rbridal/smart-blast-gate-controller/README.md

# Smart Blast Gate Controller

Automatic dust collection for a small shop: two servo-driven 2½″ ball valves
(Shapeoko CNC + spot hose) on an ESP32 running ESPHome, reed switches at both
end stops of each valve, a round touch display for status/override, and Home
Assistant deciding *when* suction is wanted (spindle current via Shelly EM,
buttons, display taps) and switching the shop vac.

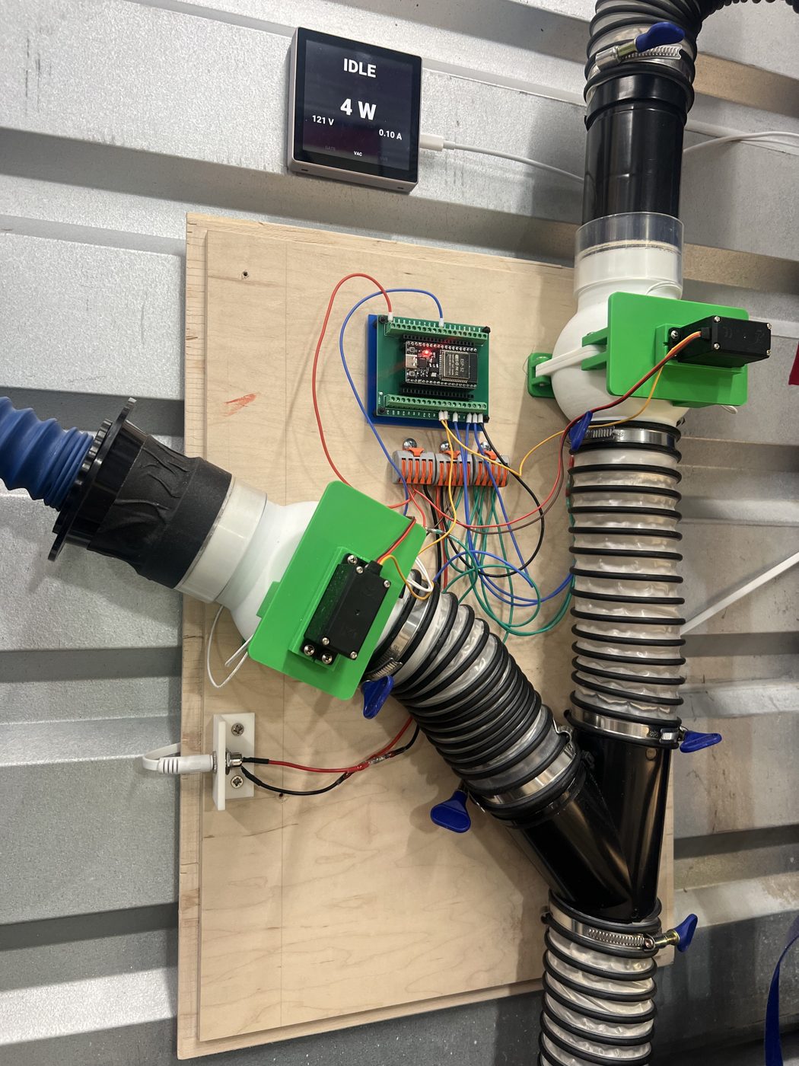
[picture p1: docs/images/install-2026-10.jpg]
Current install: dual servo blast gates and controller board on the wall panel, with the CNC display above. The enclosure top and sides are not on yet.


_Current install, October 2026. The enclosure top and sides are still to come. The panel above the gates is the CNC display._

**Secrets:** every key/password/SSID here is a `!secret` reference. Bring your own `secrets.yaml`.

## How it works (one paragraph)
HA flips a **desired** switch per gate. The ESP drives the servo to a soft %
target against a flat printed hard stop, and derives an **actual** state from
the two reeds (`closed | open | moving | unknown | fault`). A 500 ms
**alignment supervisor** on the ESP compares desired vs actual and, after a
grace + debounce window, re-drives a misaligned gate with cooldown between
retries, latching a fault after N retries. Open gates hold PWM; closed gates
detach. Closing the last open gate waits for the vac to coast down. Details:
[`docs/architecture.md`](docs/architecture.md), the *why*: [`docs/decisions/`](docs/decisions/).

## Repo map
| Path | What |
|---|---|
| `esphome/cnc-blast-gate.yaml` + `cnc-bg-p*.yaml` | Production dual-gate controller (thin main + packages, split to fit Builder upload size) |
| `esphome/prototype/` | Single-gate bench prototype (same supervisor) |
| `esphome/displays/` | ESP32-S3 round AMOLED (CO5300) status/override displays |
| `home-assistant/` | Live automation export + entity map |
| `docs/architecture.md` | Supervisor, states, timings, boot |
| `docs/wiring.md` | Pins, reeds, power, free GPIOs |
| `docs/decisions/` | ADRs — why each design choice was made |
| `docs/timeline.md` | Iteration history |
| `hardware/print/` | 3D print files (Rob's current versions — pending) |
| `hardware/lightburn/` | Laser faceplate / label / reed-plate SVGs |
| `hardware/legacy-blast-gate-c/` | Earlier "Blast Gate C" no-reed config + horn-flag reed mounts (superseded) |

### Which display config is current

- **Daily driver (still):** `esphome/displays/shop-cnc-display.yaml` (device `shop-cnc-display`, "Shop CNC Display") — Guition 4848S040 480×480. Retire only after the Tough is online.
- **Next (M5Stack Tough, not flashed yet):** `esphome/displays/smart-blast-gate-display.yaml` (device `smart-blast-gate-display`, "Smart Blast Gate Display") — ILI9342C 320×240 + AXP192 + CHSC6540 poll; CNC Display logic scaled for 2".
- **Archived 2026-10-31:** `esphome/displays/archive/` — old round CO5300 Smart Blast Gate Display + Shop Bambu Display (copied from Shop HA).
- Prototype: `smart-blast-gate-prototype-display.yaml` kept for reference.

The controller (`esphome/cnc-blast-gate.yaml`) pulls its packages from `cnc-bg-p1`, `p2a`, `p2b`, `p2c`, `p3a` and `p3b`. All keys, passwords and Wi-Fi values come from `!secret` entries in your own `secrets.yaml` (not in this repo), e.g. `smart_blast_gate_api_key`.

## Bill of materials (as known)
| Qty | Part | Notes |
|---|---|---|
| 1 | ESP32 DevKit, 38-pin (`esp32dev`) | Controller |
| 2 | MG996R servo | **Metal 25T horns + threadlocker** (stock horns stripped). The printed parts are modeled around the [MECCANIXITY metal 25T single-arm servo horn](https://www.amazon.com/dp/B0G2CFPKC6) (aluminum, split clamp, 28 mm long, 7.5 mm thick, 3 mm hole). |
| 2 | 2½″ printed ball valve (case/rotator/bearings) | PLA (PETG was too fragile); TPU flange seals |
| 4 | RC-34A-style reed switch | One per end stop, set in the printed stops |
| 2+ | Small neodymium magnets | On the 60 mm double horn |
| 2 | 5 V supplies (servo / logic) | Common GND — see ADR 0007. Ratings: **unknown** |
| 1 | Shelly EM Gen3 + CT clamp | Spindle-running sense |
| 1 | YoLink smart outlet | Shop vac |
| — | Woodcraft 2½″ hose + WoodRiver Y fitting | Ducting |
| 1 | ESP32-S3 1.8–2.16″ round AMOLED (CO5300) | Display / override (exact board: see display YAML) |

## Flashing
ESPHome Builder → device → Validate → Install. Rollback = previous YAML in git.
