rbridal/smart-blast-gate-controller/docs/decisions/README.md

# Decisions (ADRs)

Status of all: **Accepted**. Rationale marked _reconstructed_ where it wasn't explicitly recorded.

- [0001 Hobby servos instead of NEMA17 / 28BYJ-48 steppers](0001-servos-over-steppers.md)
- [0002 Metal 25T horns + threadlocker](0002-metal-horns-threadlocker.md)
- [0003 Flat printed hard stops + soft % targets (not stall-to-limit)](0003-hard-stops-soft-targets.md)
- [0004 Reeds inside the stops; magnets on the 60 mm double horn; catch magnets removed](0004-reeds-in-stops.md)
- [0005 Hold PWM while open; detach only when closed](0005-hold-open-detach-closed.md)
- [0006 Alignment supervisor lives on the ESP; HA switches are desired-only](0006-supervisor-on-esp.md)
- [0007 Dual 5 V supplies with common ground](0007-dual-5v-common-ground.md)
- [0008 Last-gate close delay](0008-last-gate-close-delay.md)
- [0009 Shelly EM + CT for spindle sense; VFD run relay as a future primary signal](0009-shelly-em-spindle-sense.md)
- [0010 Woodcraft 2½″ hose + WoodRiver Y](0010-ducting.md)
- [0011 open % / closed % mapping](0011-percent-mapping.md)
