rbridal/smart-blast-gate-controller/docs/decisions/0010-ducting.md

# 0010 — Woodcraft 2½″ hose + WoodRiver Y

**Context.** Standard 2½″ shop-vac ducting.

**Decision.** Woodcraft 2½″ hose with a WoodRiver Y splitting CNC and spot hose.

**Consequences.** Valves sized to 2½″.
