rbridal/smart-blast-gate-controller/DIRECTIVES.md

# smart-blast-gate-controller — Directives

Memorial of the dual-valve ESPHome smart blast gate controller for CNC dust collection.

## Ownership
- **Masta-Rob** owns this home project DIRECTIVES.md. Flag Rob only for policy changes.

## Safety (always wins)
- Do not revive or flash hardware from this memorial without a new Rob-approved project plan.

## Directives (priority order, highest first)
- Keep as historical reference; new dust-collection / air-blast work belongs in its own active project.

## Non-goals
- Not an active deployment target.

## Standing rules that apply here
- Nothing flashed or deployed without Rob's OK.

## Change log
- 2026-11-04 — Masta-Rob — Initial DIRECTIVES.md marking memorial status (Rob's OK: yes, pt1410u).
