rbridal/smart-blast-gate-controller/hardware/print/smart-blast-gate.3mf

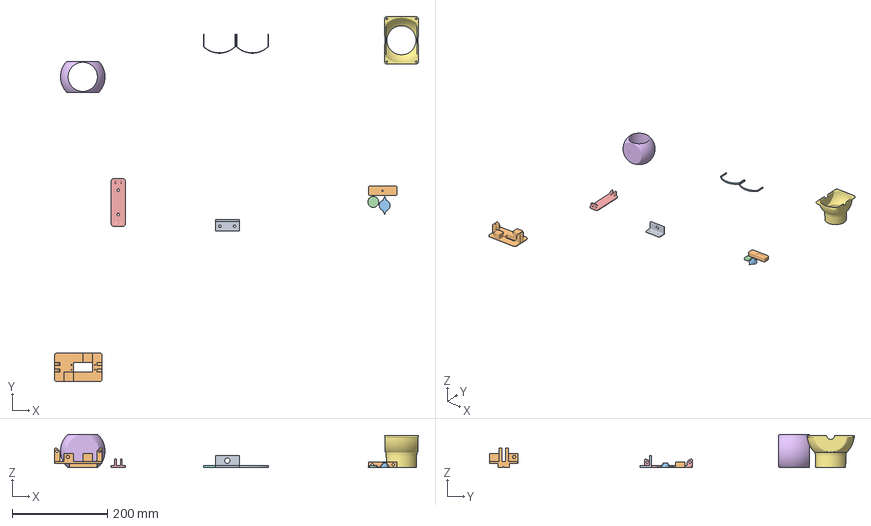
[picture p2: CAD file, 2026-10-14]
hardware/print/smart-blast-gate.3mf
763.1 x 765.7 x 69.7 mm
flange-seal.stl x 2
Smart Blast Gate Servo Mount (21).stl
Smart Blast Gate Servo Mount (13).stl
Smart Blast Gate Servo Mount (15).stl
Smart Blast Gate Servo Mount (4).stl
rotator.stl
Smart Blast Gate Outside Shell.stl
Smart Blast Gate Servo Mount (5).stl
Smart Blast Gate Servo Mount (26).stl
