rbridal/smart-blast-gate-controller/hardware/legacy-blast-gate-c/reed-bracket-servo-side.stl

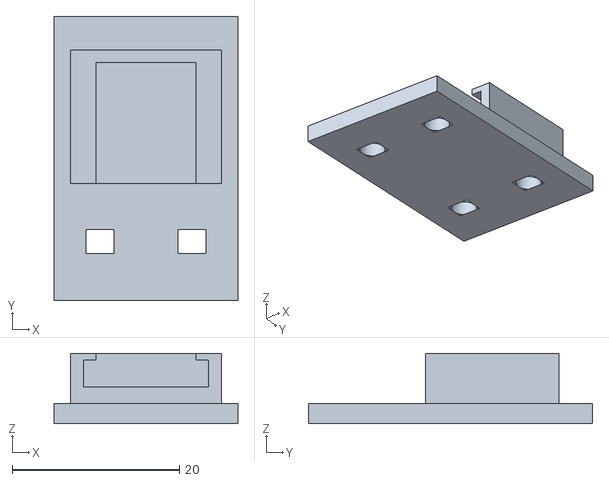
[picture p3: CAD file, 2026-10-14, an earlier design]
hardware/legacy-blast-gate-c/reed-bracket-servo-side.stl
22.0 x 34.0 x 8.40
