rbridal/smart-blast-gate-controller/hardware/legacy-blast-gate-c/mg996r-horn-flag-magnet.stl

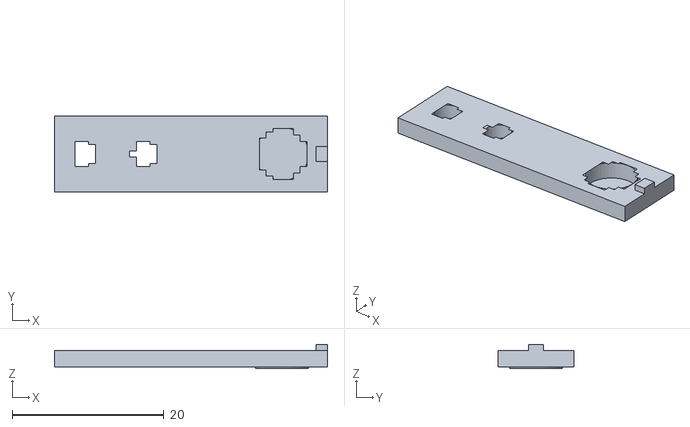
[picture p4: CAD file, 2026-10-14, an earlier design]
hardware/legacy-blast-gate-c/mg996r-horn-flag-magnet.stl
36.0 x 10.0 x 3.20
