rbridal/smart-blast-gate-controller/hardware/legacy-blast-gate-c/reed-bracket-ziptie-pad.stl

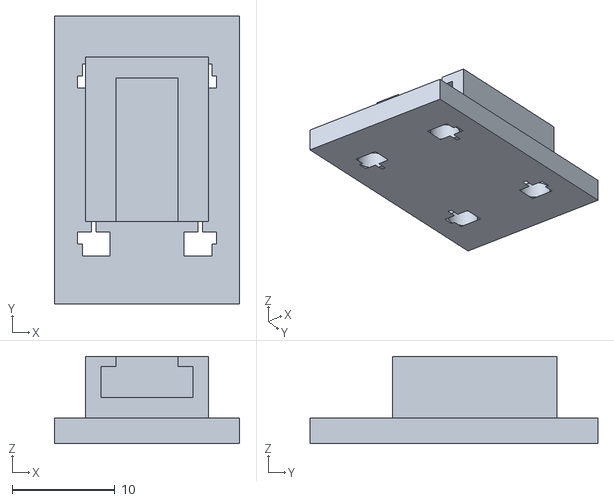
[picture p5: CAD file, 2026-10-14, an earlier design]
hardware/legacy-blast-gate-c/reed-bracket-ziptie-pad.stl
18.0 x 28.0 x 8.50
