rbridal/smart-blast-gate-controller/(commit log)

2026-10-14 Initial memorial: redacted production dual-valve ESPHome config + packages + README
2026-10-14 Add remaining package parts: scripts, switches, numbers, and supervisor interval
2026-10-14 Restructure: architecture, ADRs, wiring, timeline, HA export, prototype/display YAMLs, hardware
    [mg996r-horn-flag-magnet.stl, reed-bracket-servo-side.stl, reed-bracket-ziptie-pad.stl]
2026-10-14 Add Rob's Bambu Studio print project + print README
    [smart-blast-gate.3mf]
2026-10-14 Print parts are PLA (PETG proved too fragile)
2026-10-14 Add current install photo
2026-10-14 Document the MECCANIXITY metal servo arm the print model fits
2026-10-24 Sync ESPHome configs with live Shop HA; add current Shop CNC Display
    - cnc-blast-gate.yaml: API key now !secret smart_blast_gate_api_key; add p2c package include
    - add cnc-bg-p2c.yaml (stuck-gate reset before next move); trim cnc-bg-p2b.yaml to match
    - update cnc-bg-p1, p3a, p3b to live versions
    - add esphome/displays/shop-cnc-display.yaml (display in daily use); keep older display files
    - README: note which display config is current
    [cnc-bg-p1.yaml, cnc-bg-p3a.yaml, cnc-bg-p3b.yaml, shop-cnc-display.yaml]
2026-10-31 Archive old displays; add M5Stack Tough Smart Blast Gate Display
    - Move round CO5300 smart-blast-gate-display + Shop Bambu Display under
    esphome/displays/archive/ (secrets stay !secret refs).
    - Replace esphome/displays/smart-blast-gate-display.yaml with Tough port of
    shop-cnc-display logic (AXP192 M5TOUGH, ili9xxx 320x240, CHSC6540 I2C poll).
    - Shop CNC Display left active; no flash in this change.
    [shop-bambu-display.yaml, smart-blast-gate-display-round-CO5300.yaml, smart-blast-gate-display.yaml]
2026-10-31 fix Tough display colors, OVR tap flash, drop fake battery (v2.0.1-tough)
    invert_colors true so ILI9342C matches CNC dark theme; optimistic OVR/page
    flash on tap (no LVGL touchscreen); remove AXP192 battery_level (-272%).
    [smart-blast-gate-display.yaml]
2026-10-31 Tough display font rescale for 2" panel (v2.0.1-tough)
    GATE/VAC/OVR chips 14→28; hero 40→60 and hero_sm 32→48; V/A metrics
    22→33; watts unchanged. Tighten page pads so layout fits 320x240.
    [smart-blast-gate-display.yaml]
2026-10-31 fix Tough display blacks, contrast, MOVING fill (v2.0.2-tough)
    Full LVGL framebuffer so page bg paints on ili9xxx; 100% backlight;
    brighter OFF/chip neutrals; vivid MOVING orange; BGR+20MHz SPI.
    [smart-blast-gate-display.yaml]
2026-10-31 Retire Shop CNC Display into displays/archive
    Guition 4848S040; retired 2026-10-31; replaced by Tough Smart Blast
    Gate Display. Template helpers named shop_cnc_display_* stay in HA.
    [shop-cnc-display.yaml]
2026-11-05 ADR 0009: record why Shelly was used and plan the VFD run relay as the primary signal (#3)
